ew18b057/Bachelorarbeit/hardware documentation/tessel-v2.pdf

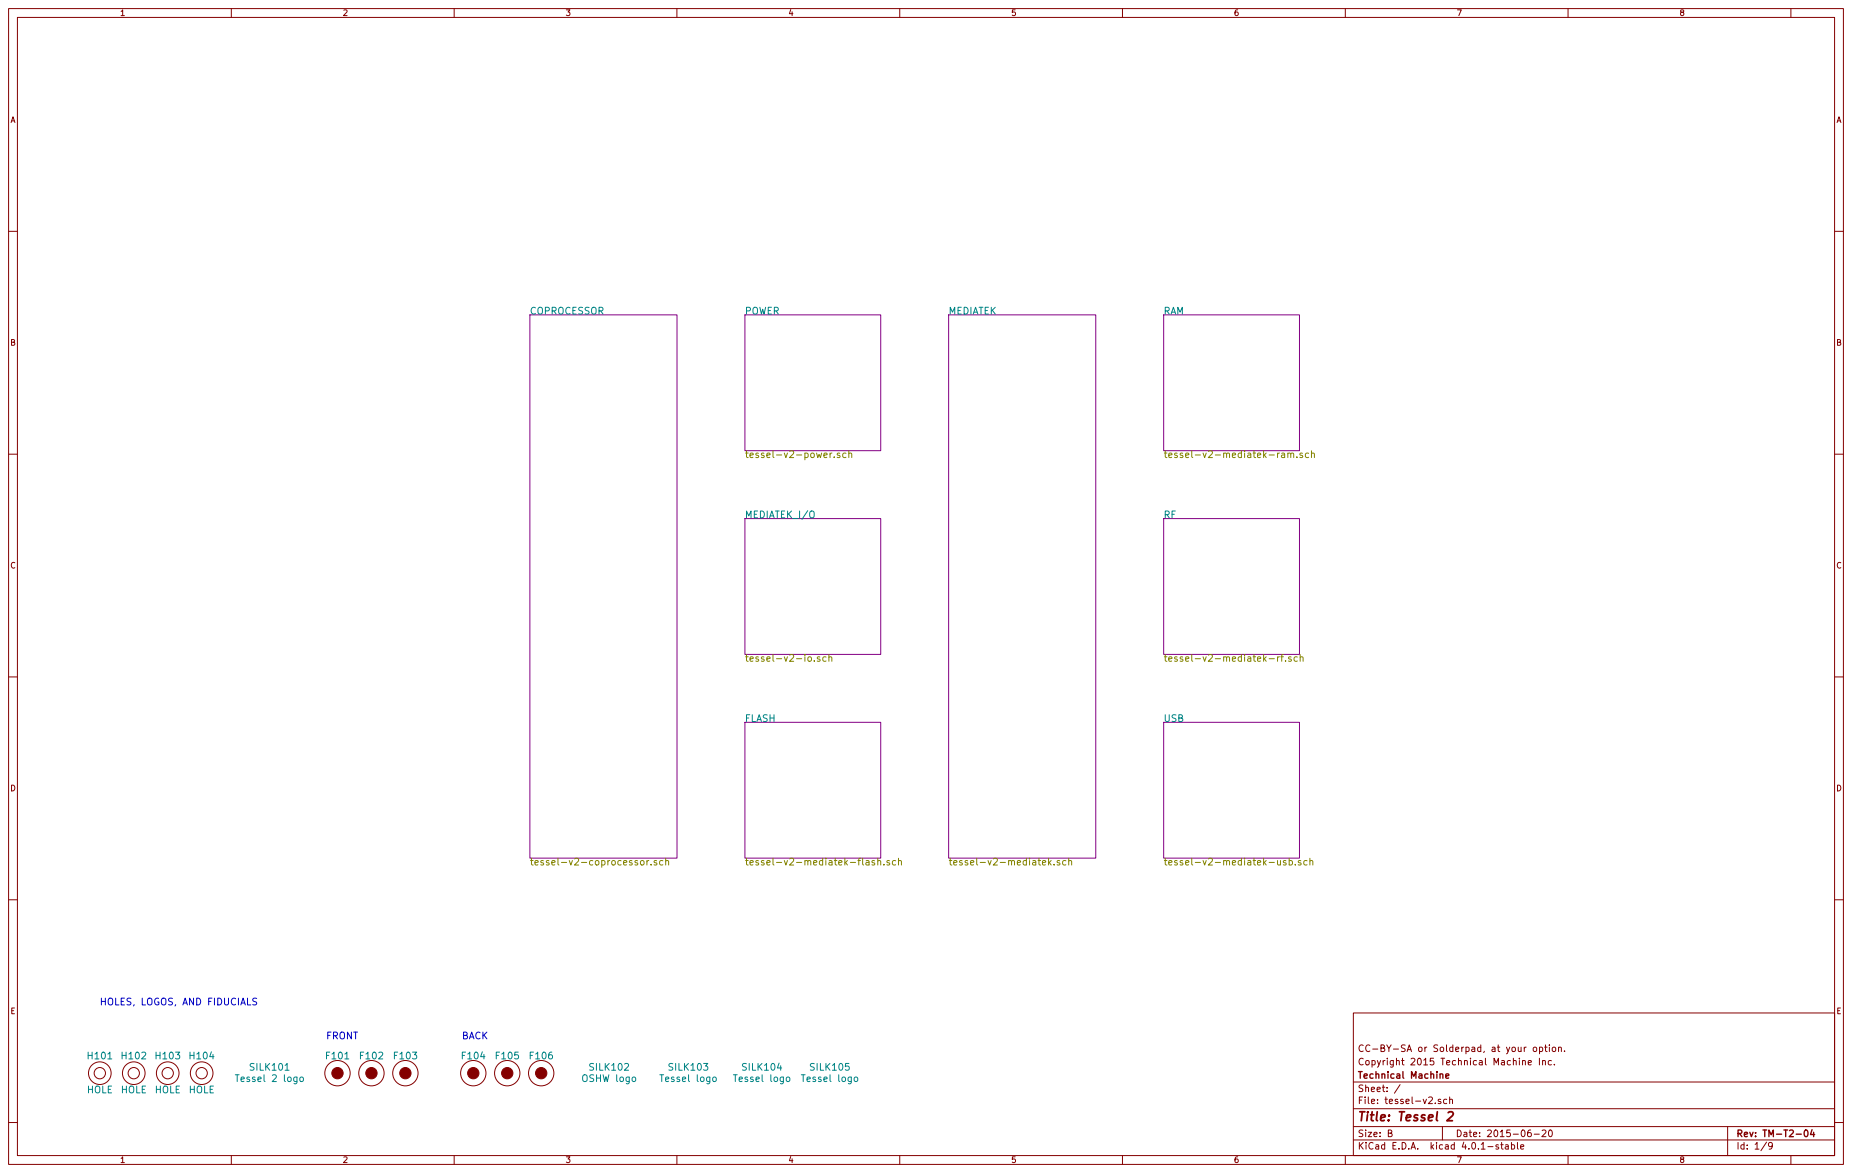
[picture p61: page 1]

tessel-v2-mediatek-ram.sch RF

tessel-v2-mediatek-rf.sch MEDIATEK_I/O

tessel-v2-io.sch FLASH

HOLES, LOGOS, AND FIDUCIALS

CC-BY-SA or Solderpad, at your option.
File: tessel-v2.sch Sheet: / Technical Machine Copyright 2015 Technical Machine Inc.

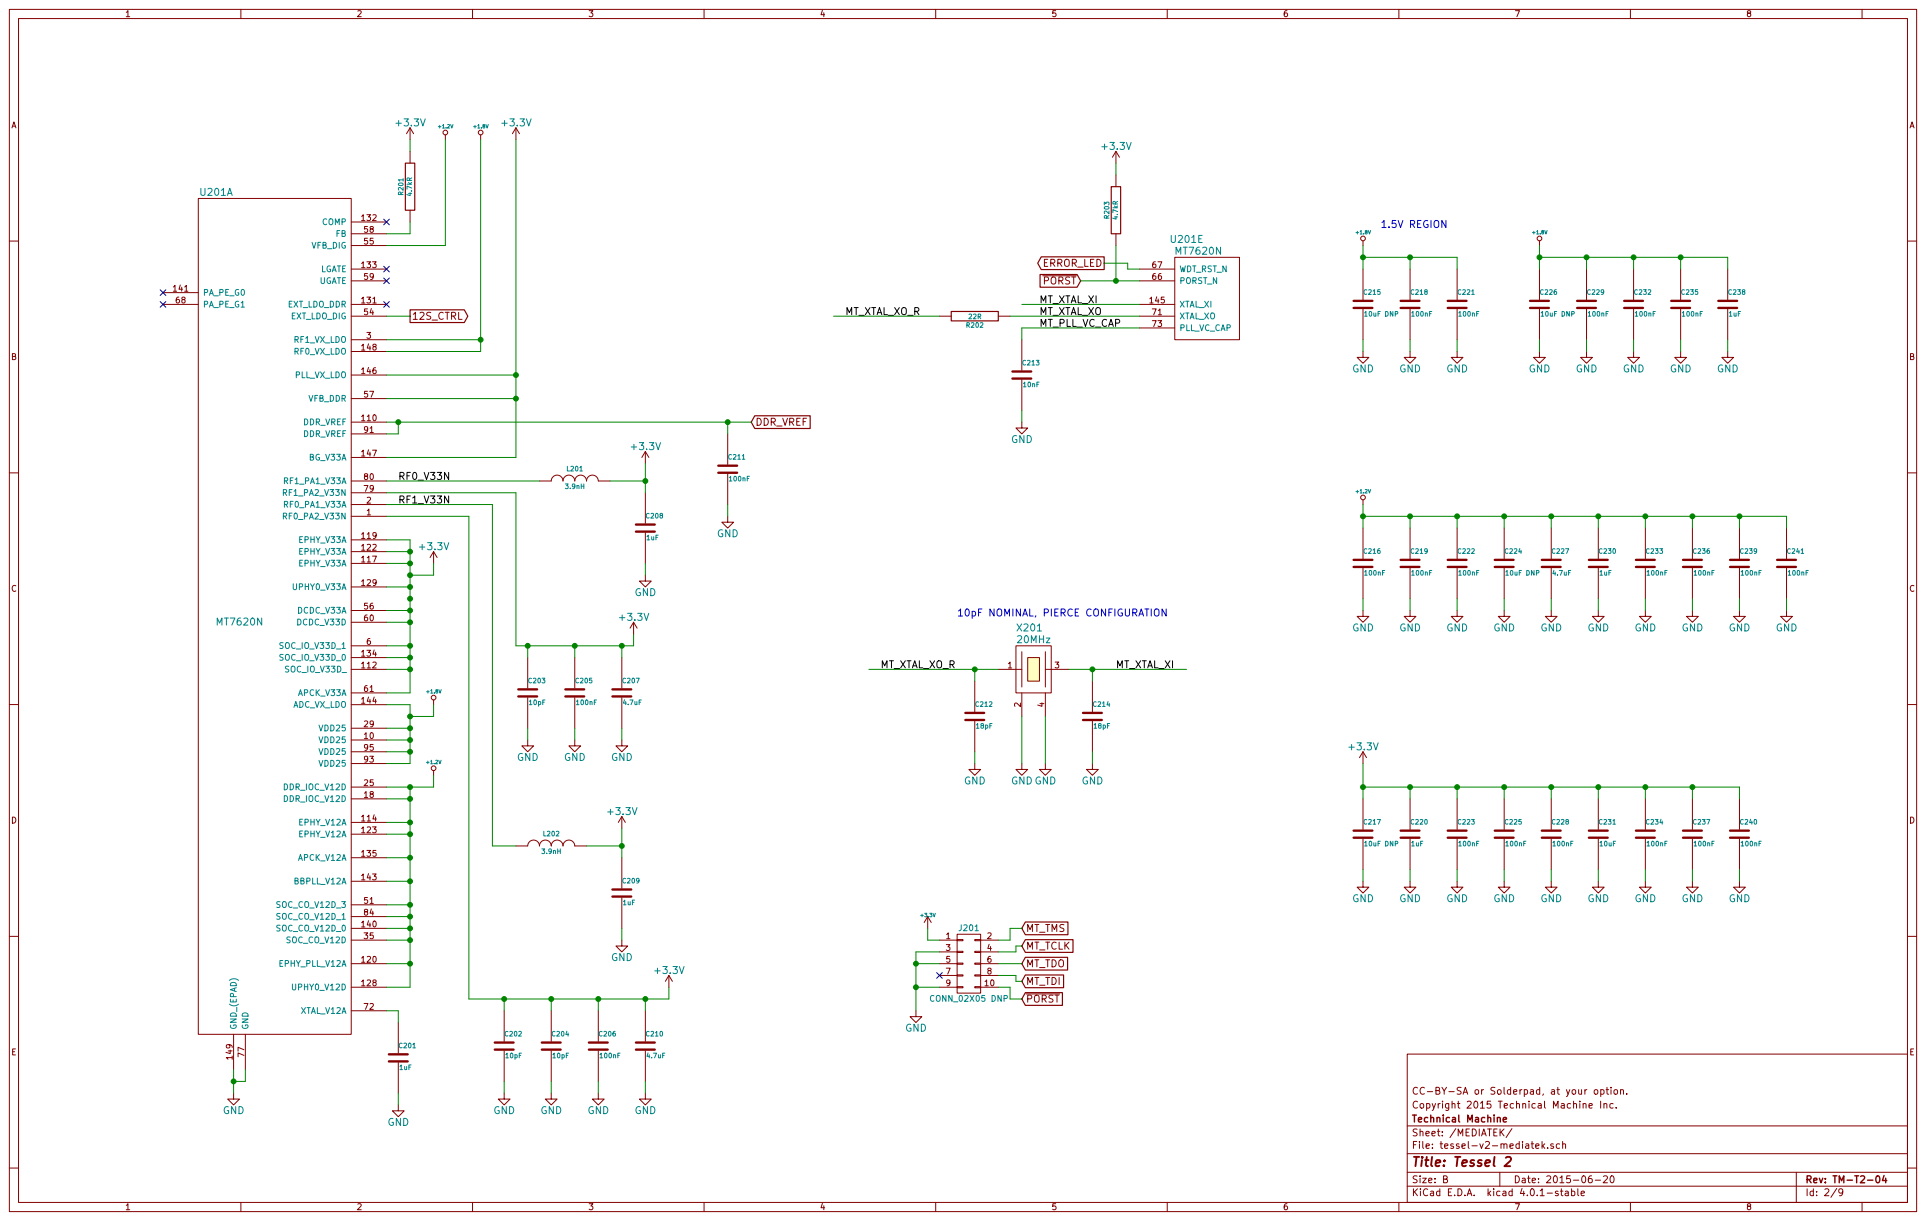
[picture p62: page 2]

CC-BY-SA or Solderpad, at your option.
File: tessel-v2-mediatek.sch Sheet: /MEDIATEK/ Technical Machine Copyright 2015 Technical Machine Inc.

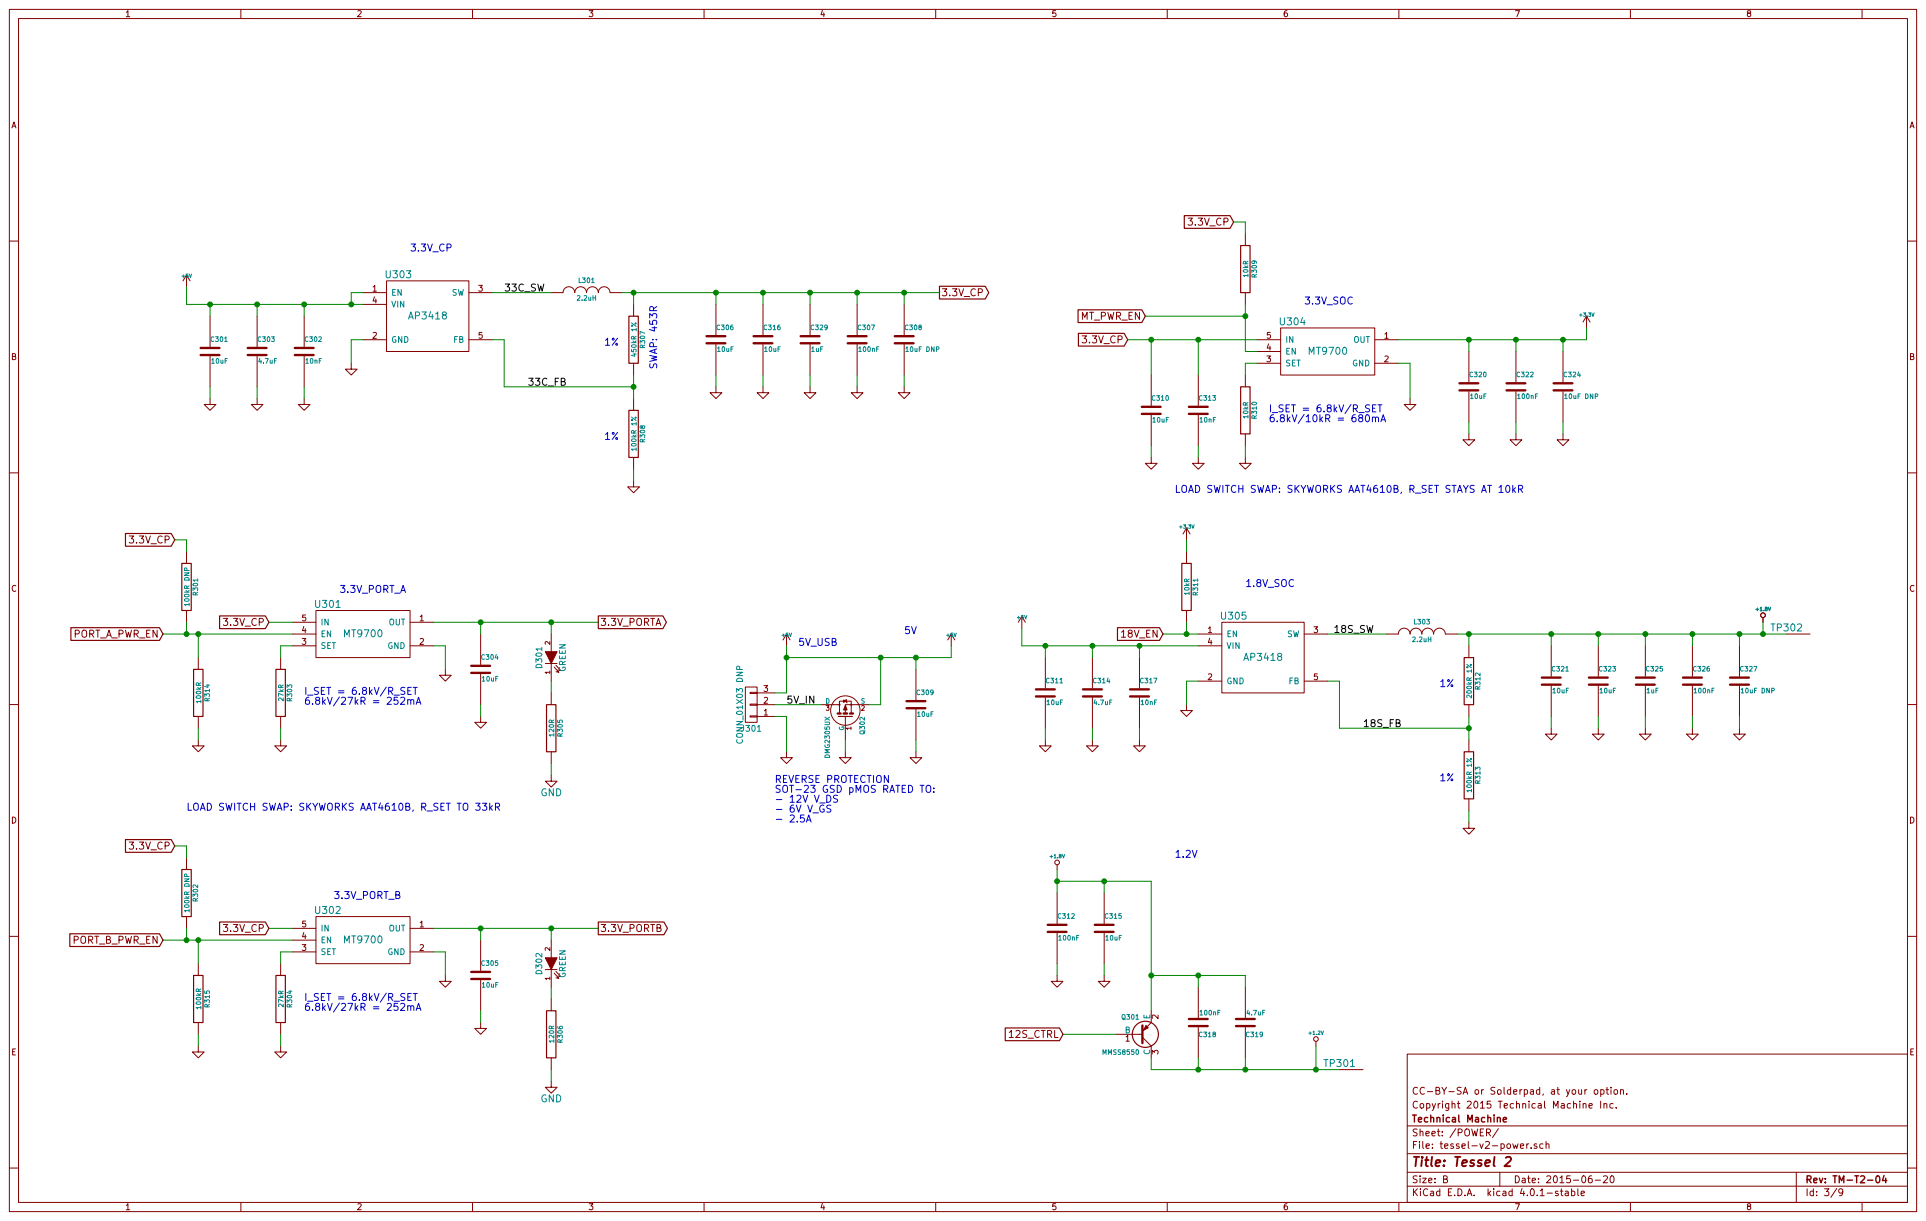
[picture p63: page 3]

LOAD SWITCH SWAP: SKYWORKS AAT4610B, R_SET STAYS AT 10kR

LOAD SWITCH SWAP: SKYWORKS AAT4610B, R_SET TO 33kR

CC-BY-SA or Solderpad, at your option.
File: tessel-v2-power.sch Sheet: /POWER/ Technical Machine Copyright 2015 Technical Machine Inc.

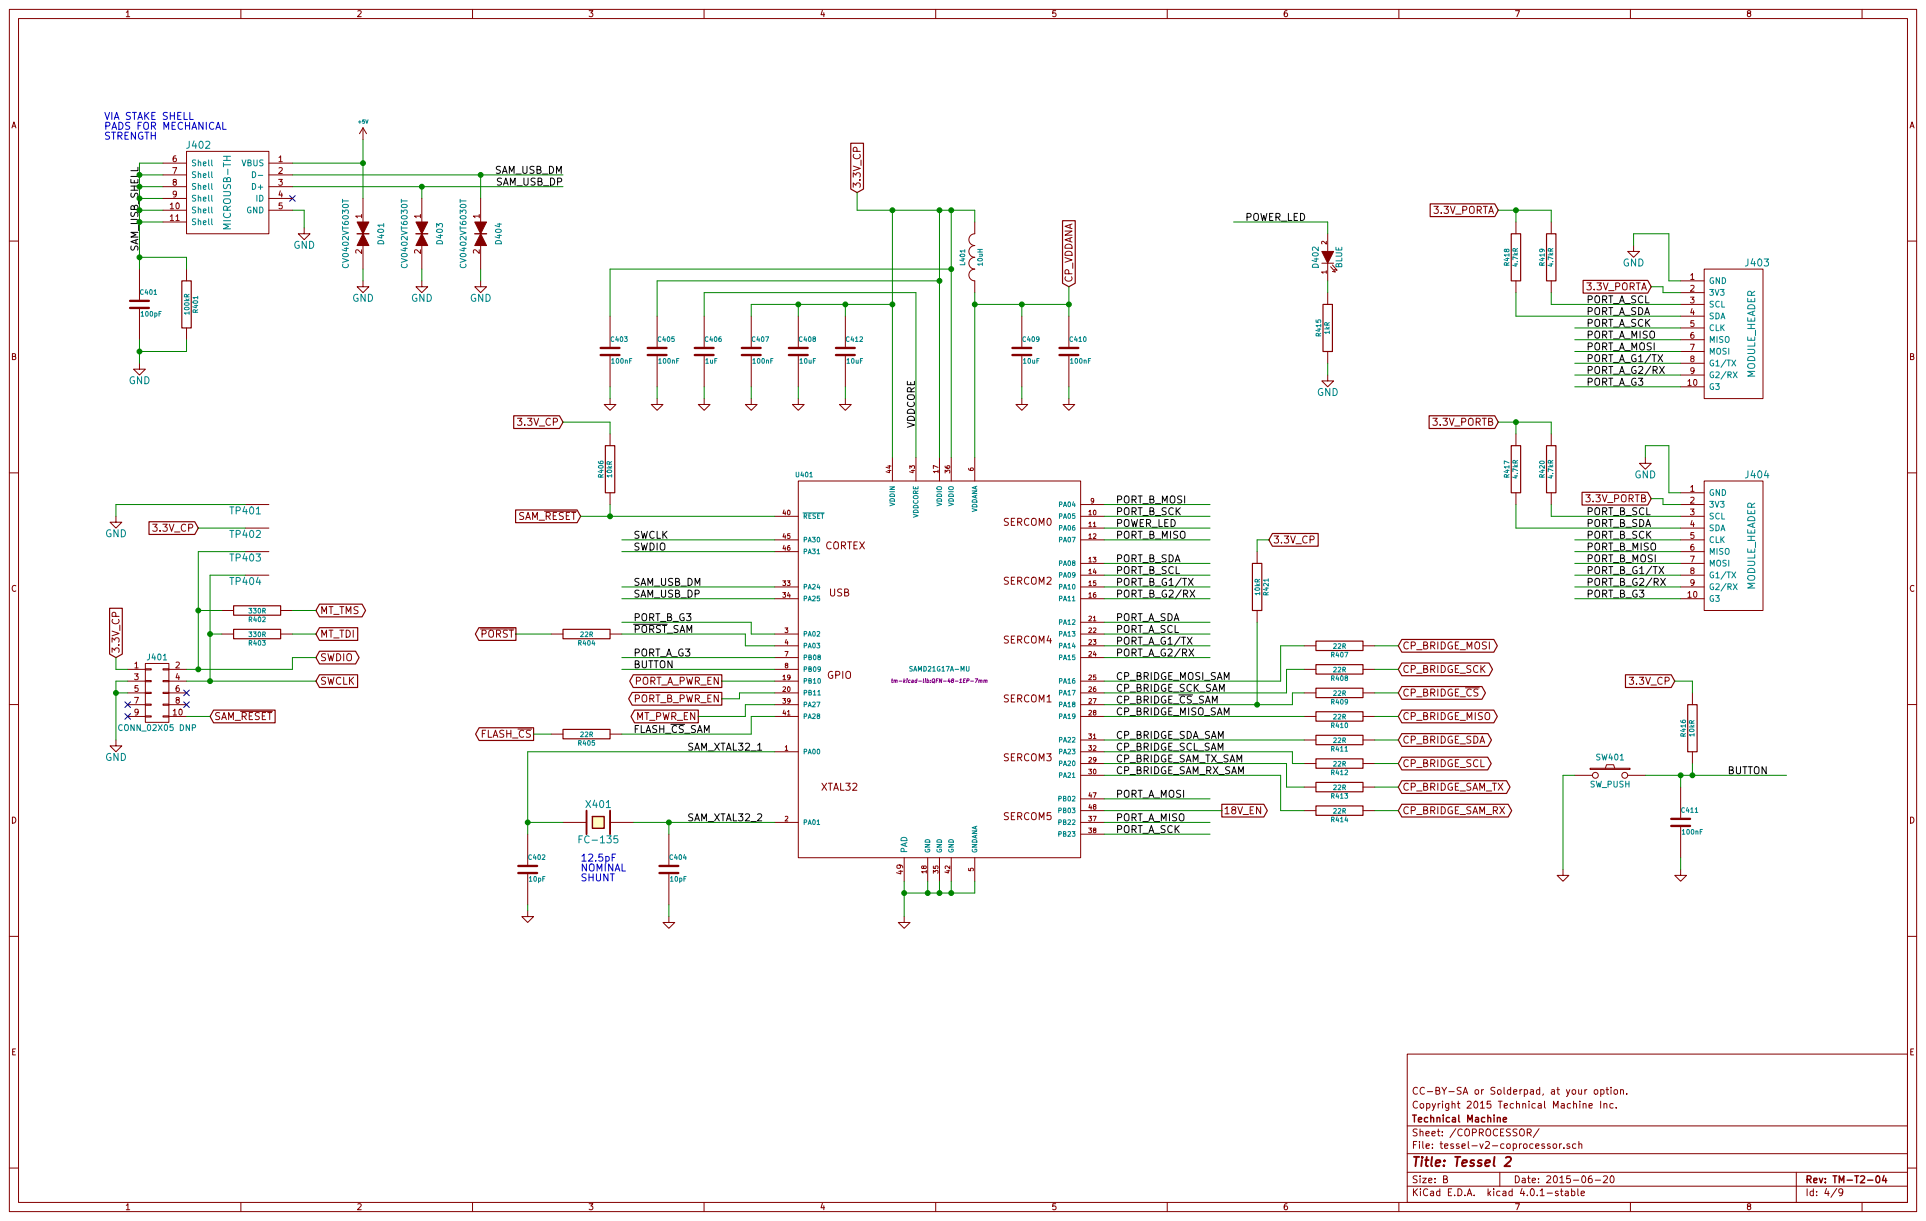
[picture p64: page 4]

tm-kicad-lib:QFN-48-1EP-7mm VDDCORE

6 PB08 7 PB09 8 PA04 9 PA05 10 PB11 20 PA21 30 RESET 40 PA06 11 PA12 21 PA22 31 PA28 41 PA07 12 PA13 22 PA23 32 GND 42 PA08 13 PA14 23 PA24 33 VDDCORE 43 PA09 14 PA15 24 PA25 34 VDDIN 44 PA10 15 PA16 25 GND 35 PA30 45 PA11 16 PA17 26 VDDIO 36 PA31 46 VDDIO 17 PA18 27 PB22 37 PB02 47 GND 18 PA19 28 PB23 38 PB03 48 PB10 19 PA20 29 PA27 39 PAD 49 U401 SAMD21G17A-MU

PORT_A_SCL
PORT_A_G1/TX

CP_BRIDGE_SCL_SAM
CP_BRIDGE_SAM_TX_SAM
CP_BRIDGE_SAM_RX_SAM

CC-BY-SA or Solderpad, at your option.
File: tessel-v2-coprocessor.sch Sheet: /COPROCESSOR/ Technical Machine Copyright 2015 Technical Machine Inc.

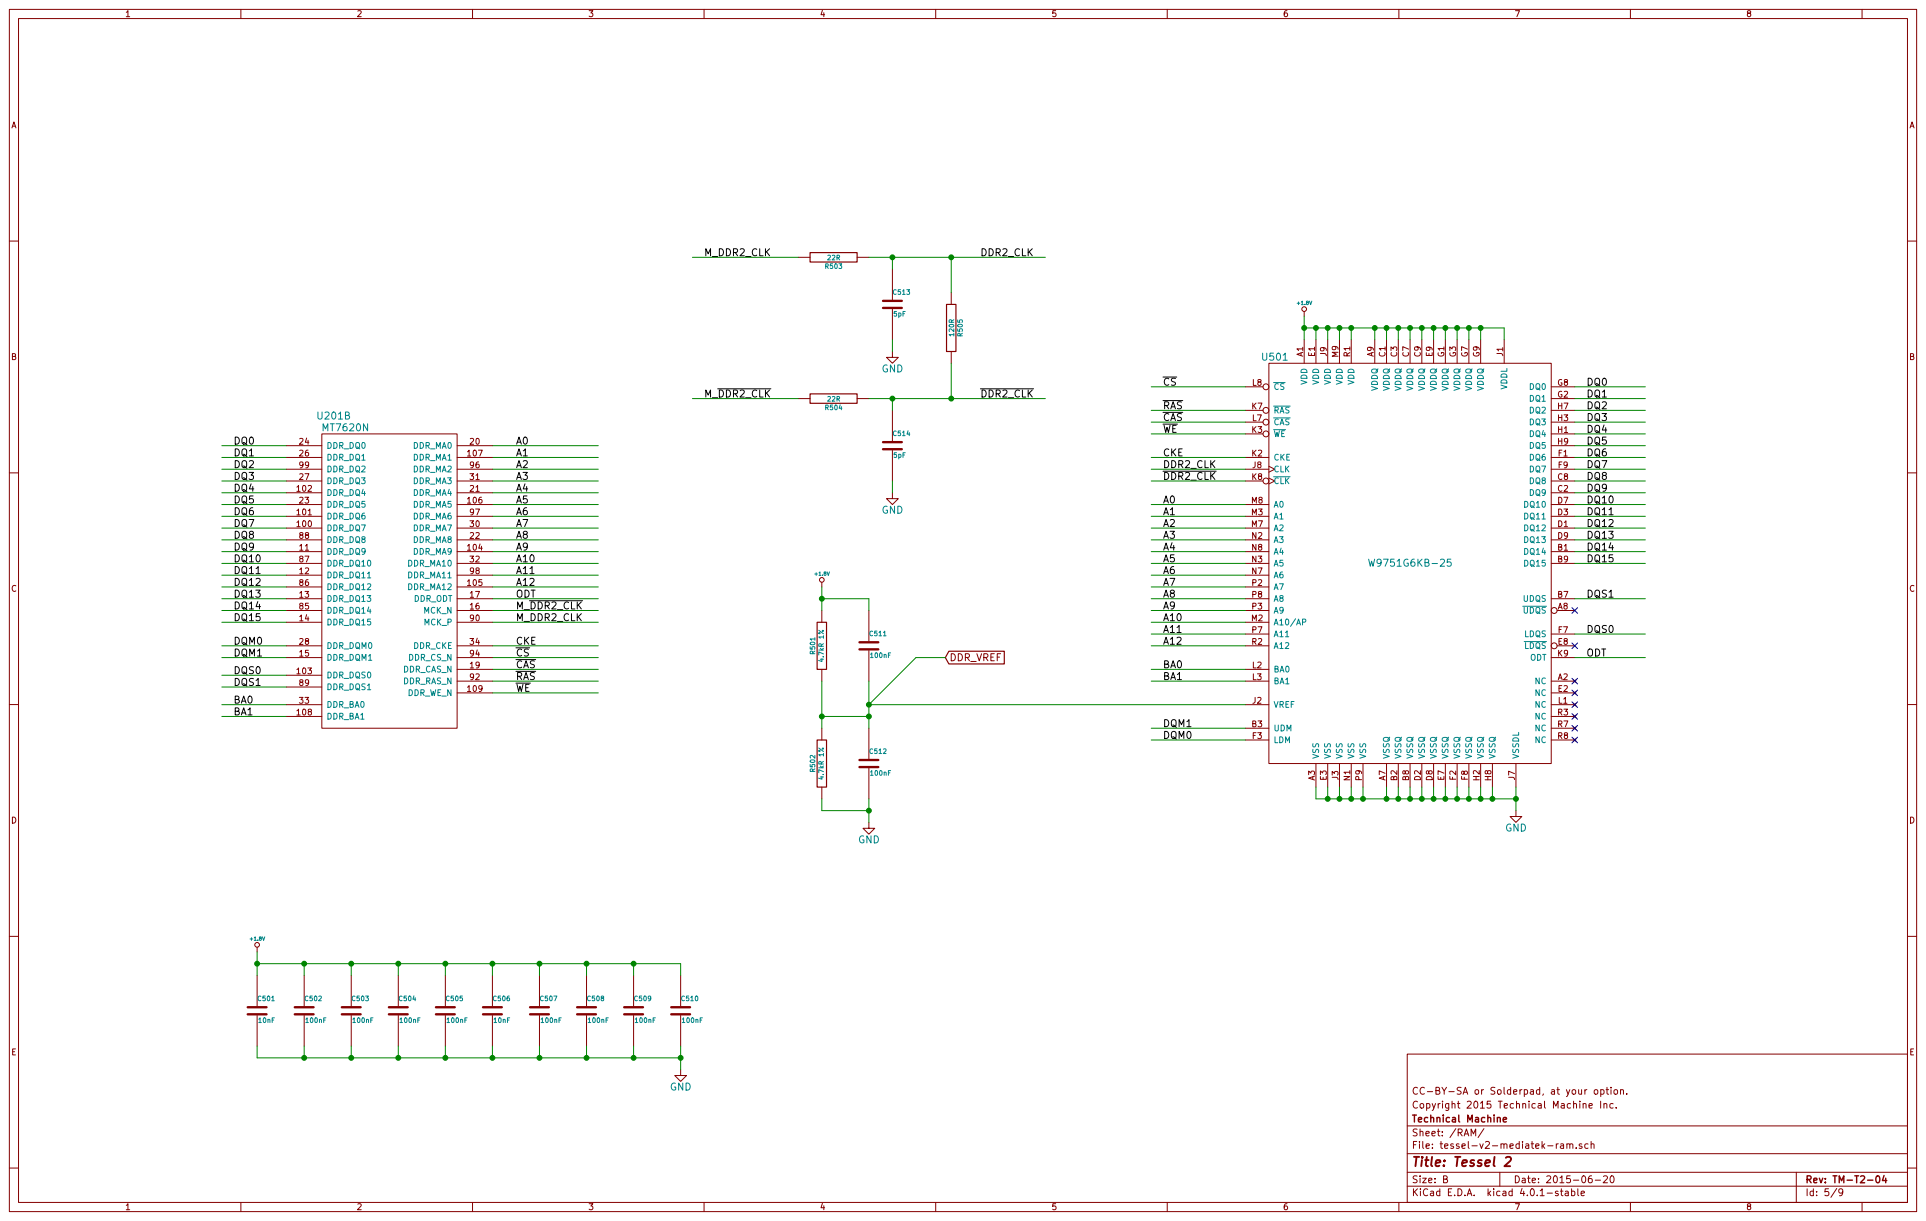
[picture p65: page 5]

File: tessel-v2-mediatek-ram.sch Sheet: /RAM/ Technical Machine Copyright 2015 Technical Machine Inc.

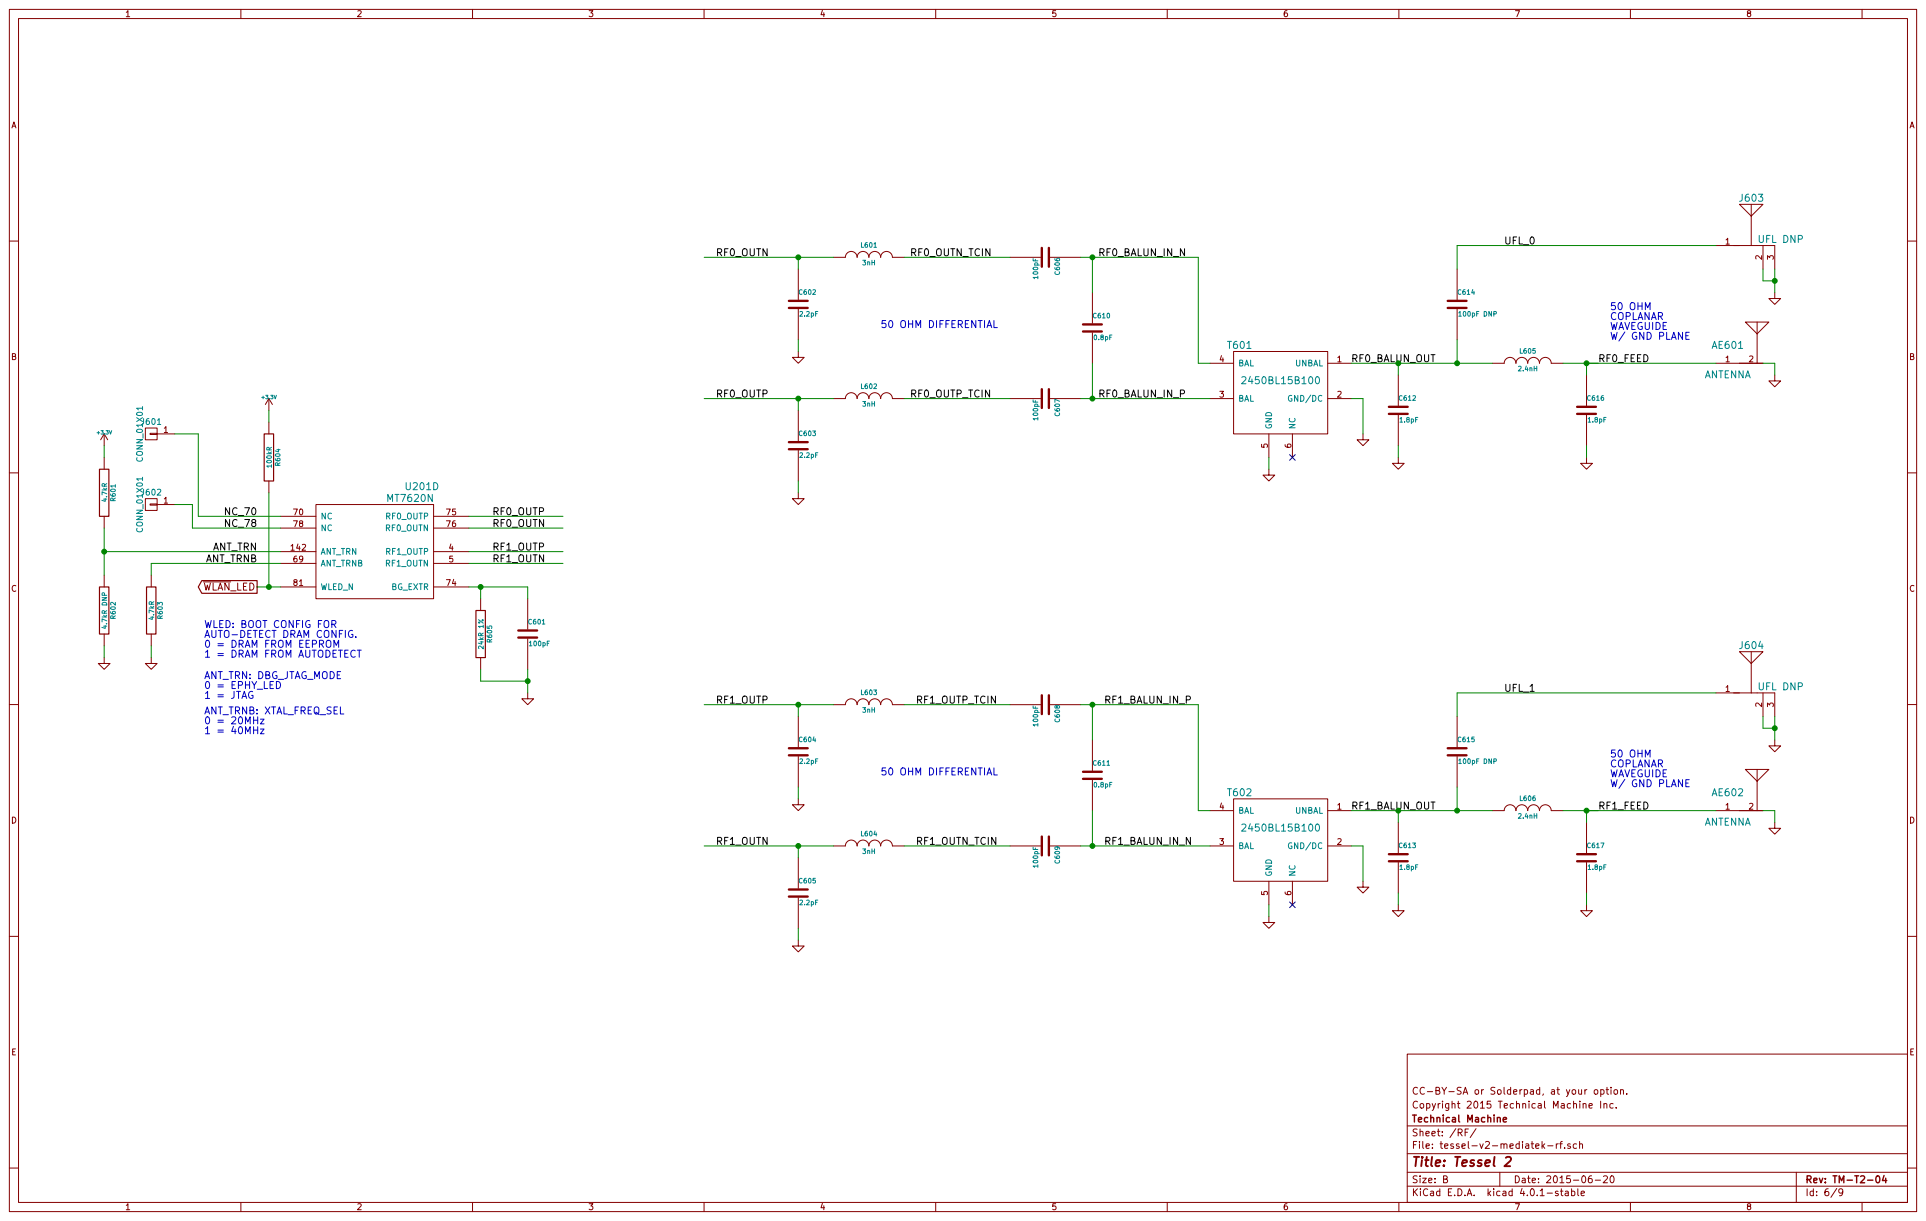
[picture p66: page 6]

CC-BY-SA or Solderpad, at your option.
File: tessel-v2-mediatek-rf.sch Sheet: /RF/ Technical Machine Copyright 2015 Technical Machine Inc.

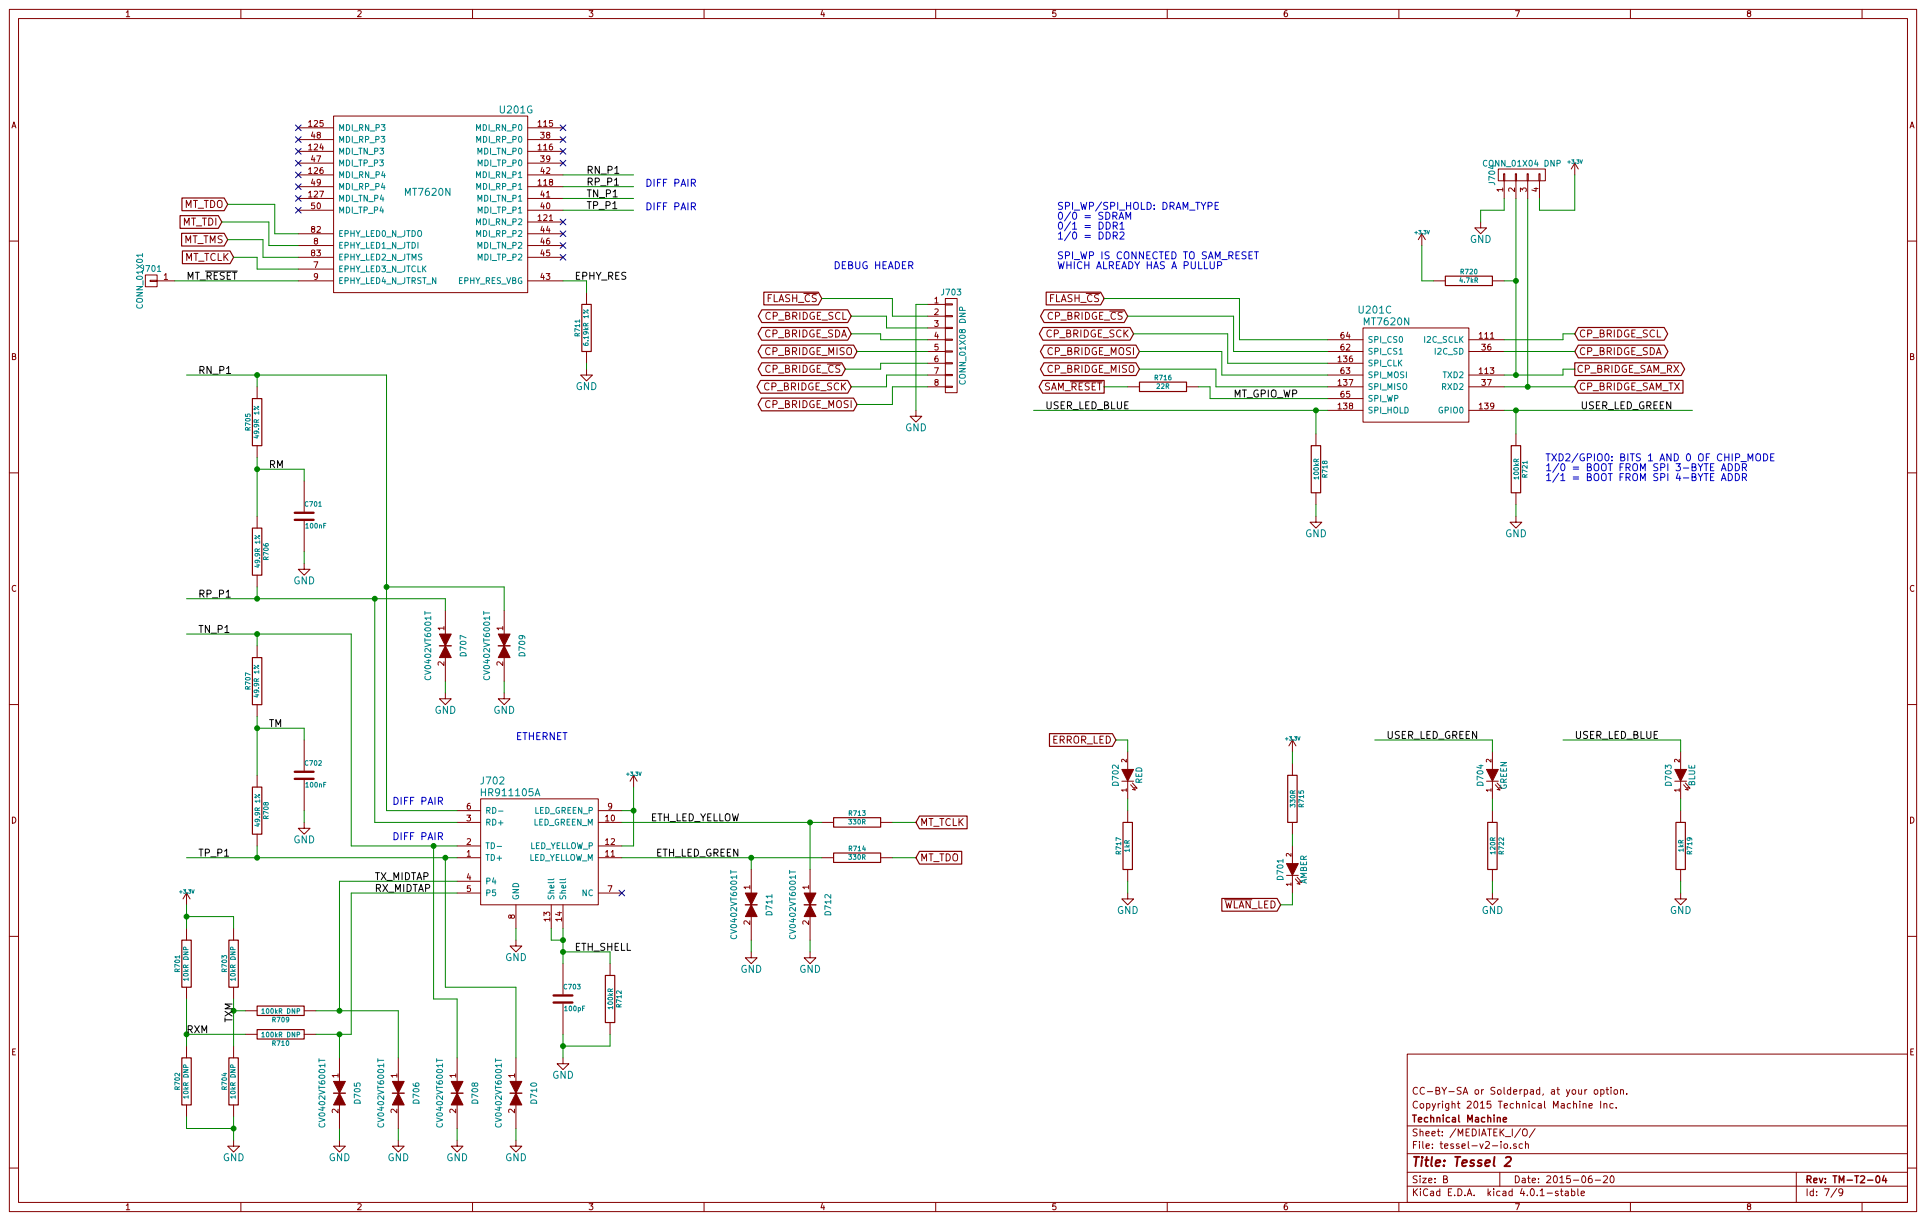
[picture p67: page 7]

5 6

1/0 = BOOT FROM SPI 3-BYTE ADDR
1/1 = BOOT FROM SPI 4-BYTE ADDR

CC-BY-SA or Solderpad, at your option.
File: tessel-v2-io.sch Sheet: /MEDIATEK_I/O/ Technical Machine Copyright 2015 Technical Machine Inc.

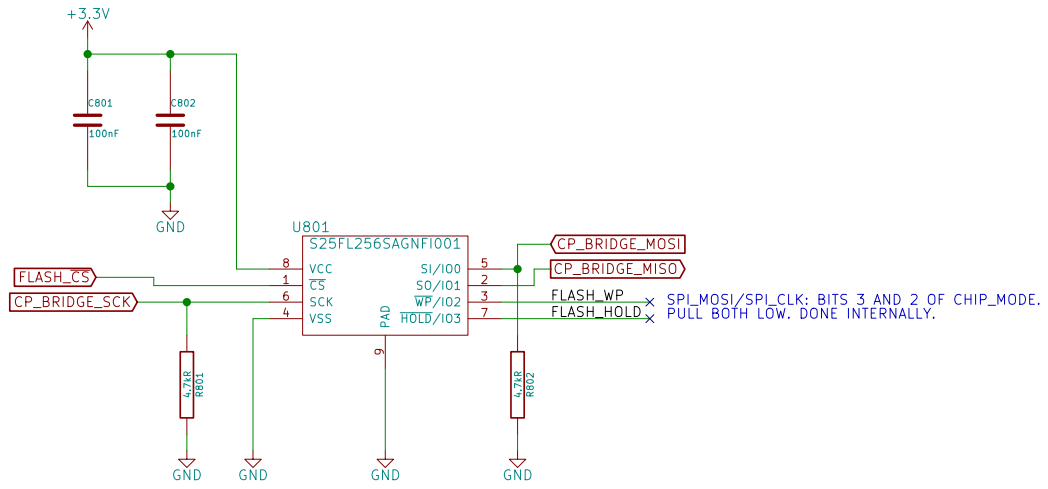
[picture p68: page 8]

CC-BY-SA or Solderpad, at your option.
File: tessel-v2-mediatek-flash.sch Sheet: /FLASH/ Technical Machine Copyright 2015 Technical Machine Inc.

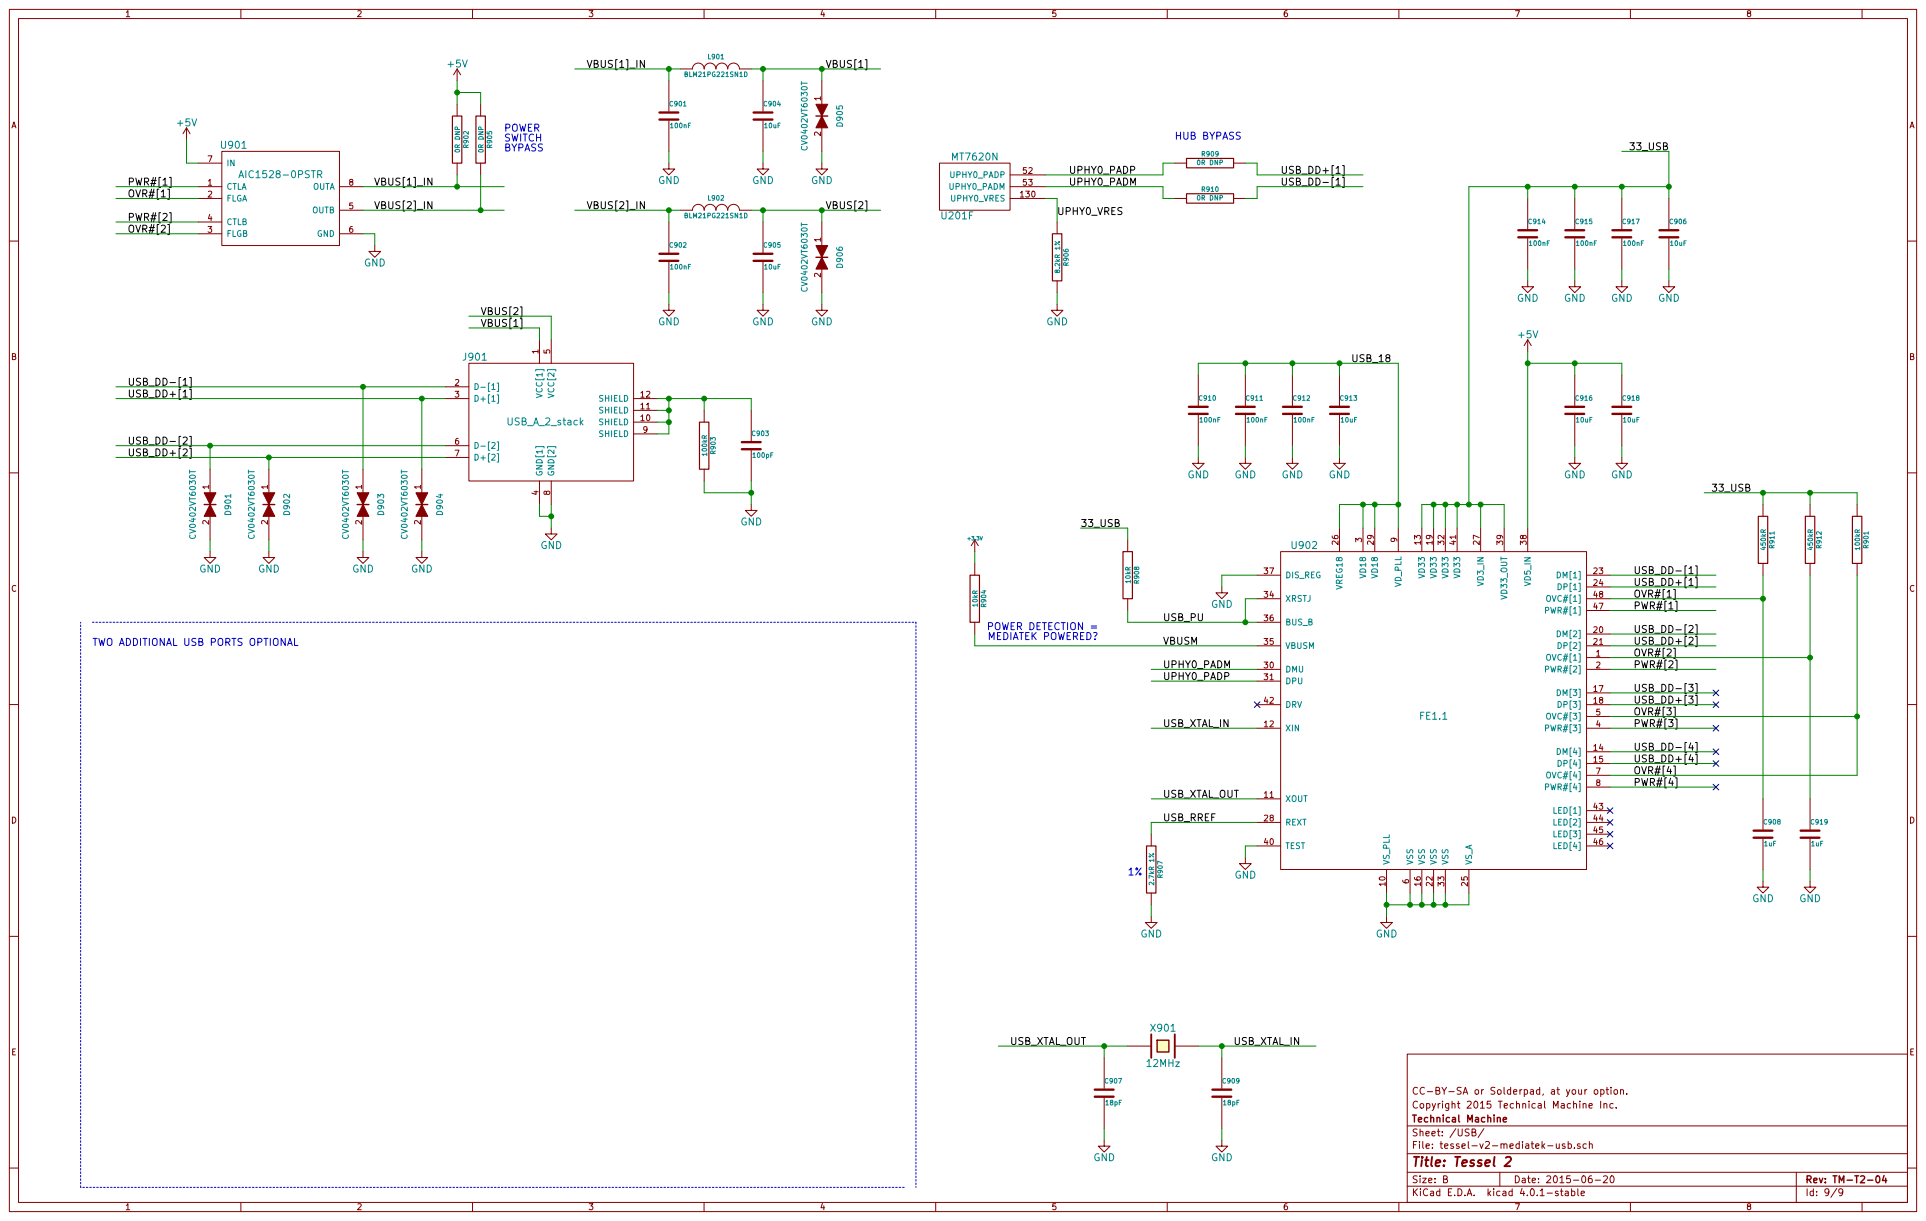
[picture p69: page 9]

CC-BY-SA or Solderpad, at your option. R906 8.2kR 1%

TWO ADDITIONAL USB PORTS OPTIONAL

File: tessel-v2-mediatek-usb.sch Sheet: /USB/ Technical Machine Copyright 2015 Technical Machine Inc.
