ew18b057/Bachelorarbeit/(list of files, drawings)

Other design files:
fritzing/input_output.fzz
