ew18b057/Bachelorarbeit/(commit log)

2020-03-19 thesis updated, fritzing created
    [input_output.fzz]
2020-03-23 chapter 6.1, 6.2 added, fritzing altered
    [input_output.fzz]
2020-05-12 flowchart in thesis updated
2020-05-13 thesis updated, final tessel-app
    [KiCad.kicad_pcb, KiCad.sch]
